adamgreig/wombat/README

WOMBAT Balloon Flight Computer
==============================

Wombat is a flight computer by Cambridge University Spaceflight featuring
onboard STM32F4, uBlox 6 GPS and ADF7012 radio.
