adamgreig/wombat/pcb/gerbers/r1/README.txt

Contents:

wombat.drl              DRILLS

wombat-Back.gbl         BOTTOM COPPER
wombat-Mask_Back.gbs    BOTTOM SOLDERMASK
wombat-SilkS_Back.gbo   BOTTOM SILKSCREEN

wombat-Front.gtl        TOP COPPER
wombat-Mask_Front.gts   TOP SOLDERMASK
wombat-SilkS_Front.gto  TOP SILKSCREEN

wombat-PCB_Edges.gbr    PCB EDGE / ROUTING
