adamgreig/wombat/misc/loopfilter/loop_filter_1_vs_2.png

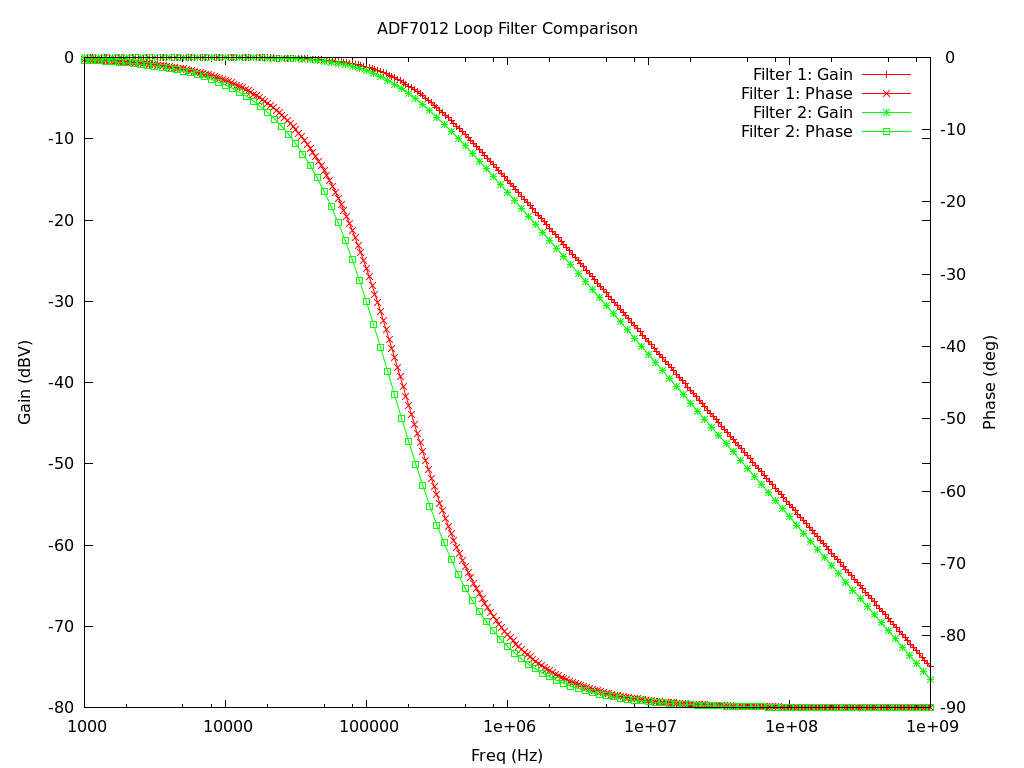
misc/loopfilter/loop_filter_1_vs_2.png
