adamgreig/wombat/misc/temperature_compensation/freq_vs_temp.png

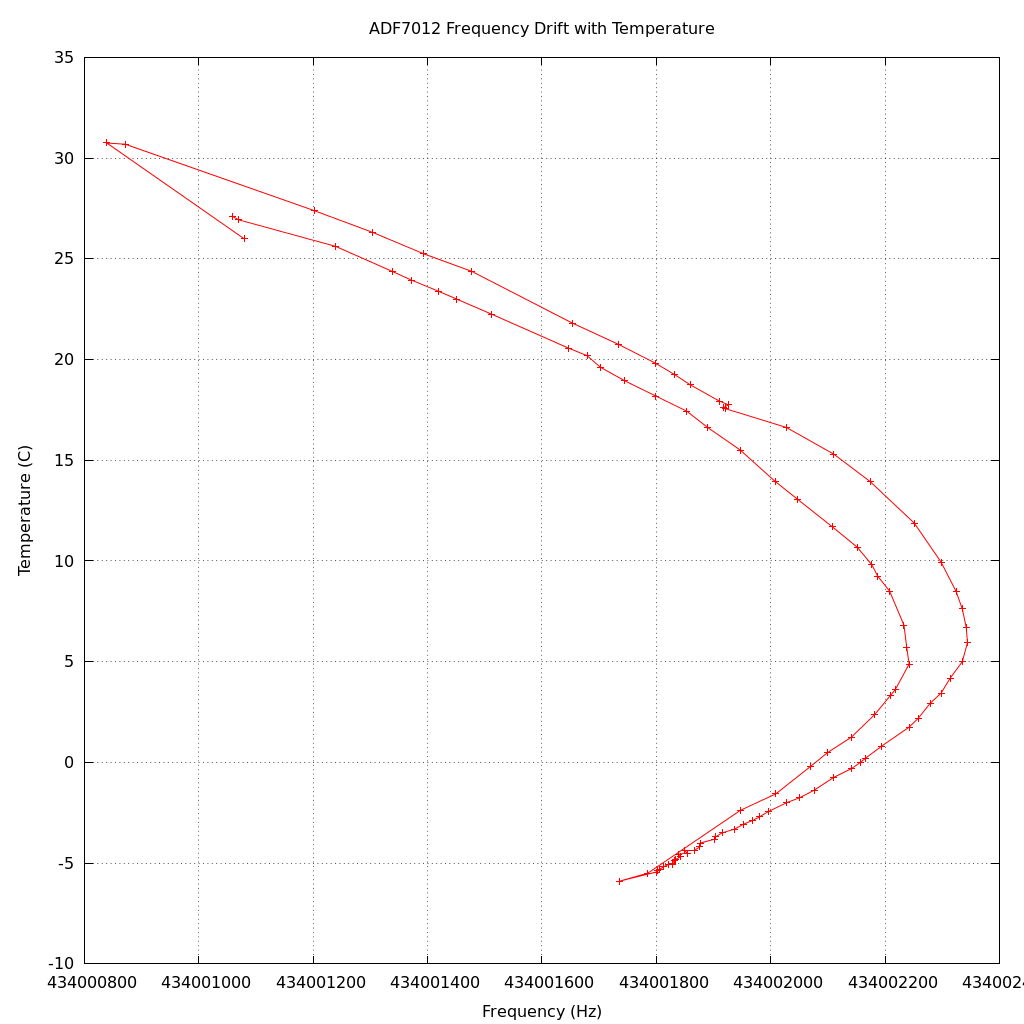
misc/temperature_compensation/freq_vs_temp.png
