adamgreig/wombat/misc/tmp102/sad.png

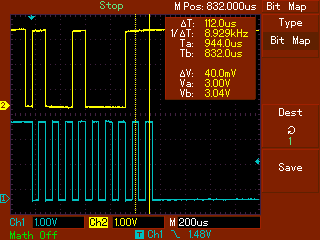
misc/tmp102/sad.png
