adamgreig/wombat/pcb/wombat.pdf

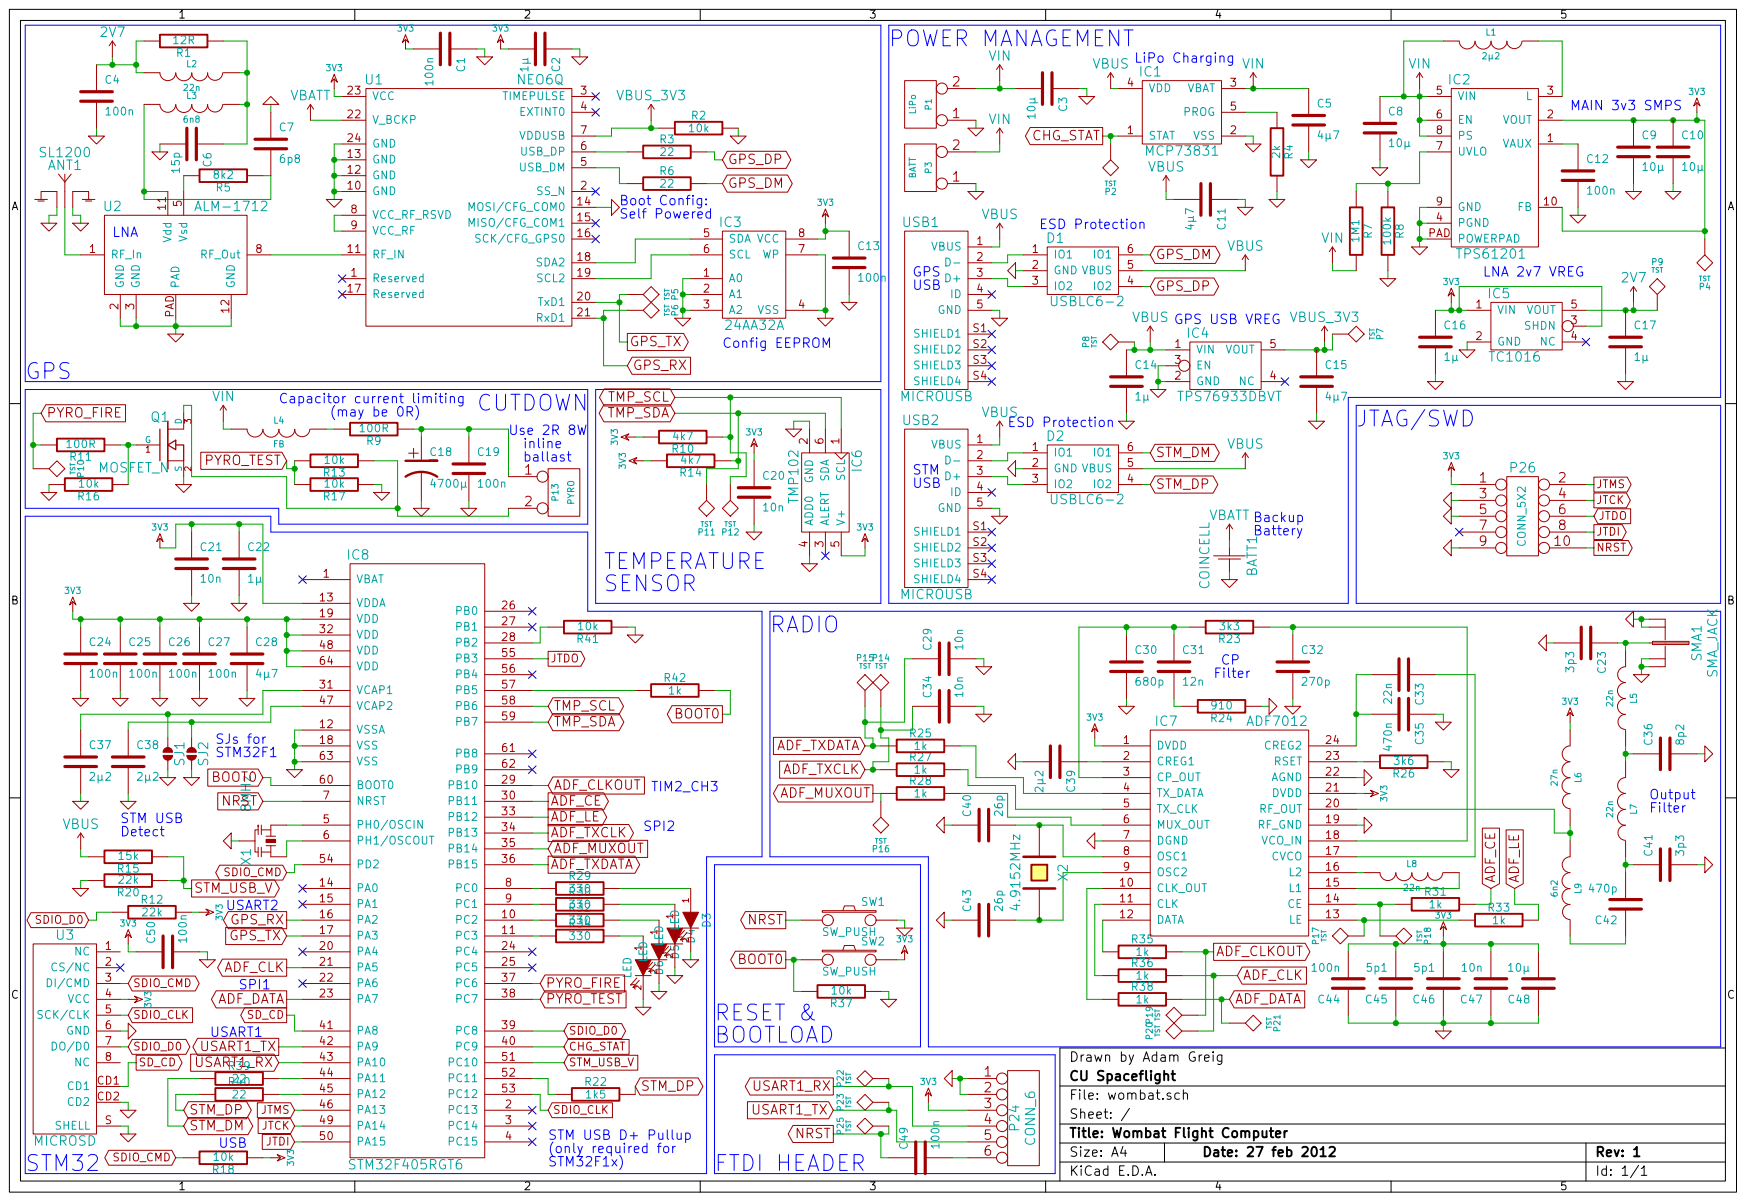
[picture p4: page 1]
