adamgreig/wombat/pcb/wombat.sch

## KiCad design pcb/wombat.sch (2012-03-08, an earlier design)

Schematic: wombat.sch

Parts:
ANT1: SL1200
BATT1: COINCELL; 2032HOLDER; Farnell 1704232
C1, C4, C12, C13, C19, C24, C25, C26, C27, C44, C49, C50: 100n; SM0402; Farnell 1828862
C2, C14, C16, C17, C22: 1µ; SM0402; Farnell 1288253
C3, C8, C9, C10, C48: 10µ; SM0603; Farnell 1735528
C5, C11, C15, C28: 4µ7; SM0603; Farnell 1833803
C6: 15p; SM0402; Farnell 1414577
C7: 6p8; SM0402; Farnell 1800799
C18: 4700µ; RADIAL-5; Farnell 1219459
C20, C21, C29, C34, C47: 10n; SM0402; Farnell 1740589
C23, C41: 3p3; SM0402; Farnell 1702752
C30: 680p; SM0402; Farnell 1865453
C31: 12n; SM0402; Farnell 1865461
C32: 270p; SM0402; Farnell 1414585
C33: 22n; SM0402; Farnell 1414583
C35: 470n; SM0402; Farnell 1414593
C36: 8p2; SM0402; Farnell 7568118
C37, C38, C39: 2µ2; SM0603; Farnell 1833808
C40, C43: 26p; SM0402; Farnell 1414584
C42: 470p; SM0402; Farnell 1535556
C45, C46: 5p1; SM0402; Farnell 1885321
D1, D2: USBLC6-2; SOT-666; Farnell 1295310
D3, D4, D5, D6: LED; SM0603; Farnell 8529850
IC1: MCP73831; SOT-23-5; Farnell 1332158
IC2: TPS61201; Farnell 1564952
IC3: 24AA32A; MSOP8; Farnell 1331296
IC4: TPS76933DBVT; SOT-23-5; Farnell 8461538
IC5: TC1016; SOT-23-5; Farnell 1825051
IC6: TMP102; SOT-563; Farnell 1652477
IC7: ADF7012; TSSOP24; Farnell 1346367
IC8: STM32F405RGT6; LQFP64; Farnell 2064363
L1: 2µ2; SM0805; Farnell 1265551
L2, L5, L7, L8: 22n; SM0402; Farnell 1669580
L3: 6n8; SM0402; Farnell 1669586
L4: FB; SM0603; Farnell 1515757
L6: 27n; SM0402; Farnell 1265429
L9: 6n2; SM0402; Farnell 1265407
P1: LiPo; JST-2mm-2; Farnell 9492615
P2, P4, P5, P6, P7, P8, P9, P10, P11, P12, P14, P15, P16, P17, P18, P19, P20, P21, P22, P23, P25: TST; TP
P3: BATT; BLOCK-3.5mm-2; Farnell 1098611
P13: PYRO; BLOCK-3.5mm-2; Farnell 1098611
P24: CONN_6; HEADER_SMD_6WAY; Farnell 9689508
P26: CONN_5X2; HEADER_SMD_2X5WAY; Farnell 1865279
Q1: MOSFET_N; SOT-23-3; Farnell 1758067
R1: 12R; SM0402; Farnell 1697293
R2, R13, R16, R17, R18, R37, R41: 10k; SM0402; Farnell 1738864
R3, R6, R39, R40: 22; SM0402; Farnell 1739071
R4: 2k; SM0402; Farnell 1358050
R5: 8k2; SM0402; Farnell 1739106
R7: 1M1; SM0402; Farnell 1458741
R8: 100k; SM0402; Farnell 1738877
R9, R11: 100R; SM0402; Farnell 1738837
R10, R14: 4k7; SM0402; Farnell 1738858
R12, R20: 22k; SM0402; Farnell 2059243
R15: 15k; SM0402; Farnell 2059240
R22: 1k5; SM0402; Farnell 2059227
R23: 3k3; SM0402; Farnell 1738856
R24: 910; SM0402; Farnell 1458832
R25, R27, R28, R31, R33, R35, R36, R38, R42: 1k; SM0402; Farnell 1738850
R26: 3k6; SM0402; Farnell 1358057
R29, R30, R32, R34: 330; SM0402; Farnell 1738843
SJ1, SJ2: SJ
SMA1: SMA_JACK; SMA_JACK_END; Farnell 1342651
SW1, SW2: SW_PUSH; SMDSWITCH; Farnell 1607971
U1: NEO6Q
U2: ALM-1712; Farnell 1865149
U3: MICROSD; Farnell 2060731
USB1, USB2: MICROUSB; Farnell 1521869
X1: 8MHz; RESONATOR; Farnell 1615352
X2: 4.9152MHz; HC49; Farnell 1640864

Notes on the sheet:
JTAG/SWD
Use 2R 8W inline ballast
Capacitor current limiting (may be 0R)
RESET & BOOTLOAD
CUTDOWN
TIM2_CH3
STM32
SPI2
USB
USART1
SPI1
USART2
SJs for STM32F1
FTDI HEADER
TEMPERATURE SENSOR
Boot Config: Self Powered
CP Filter
Output Filter
RADIO
LNA
Config EEPROM
STM USB Detect
STM USB D+ Pullup (only required for STM32F1x)
MAIN 3v3 SMPS
Backup Battery
LNA 2v7 VREG
GPS USB VREG
STM USB
GPS USB
ESD Protection
LiPo Charging
GPS
POWER MANAGEMENT
