adamgreig/wombat/code/clock.c

#include "clock.h"

#include <libopencm3/stm32/f4/rcc.h>

void clock_setup(void) {
    rcc_clock_setup_hse_3v3(&hse_8mhz_3v3[CLOCK_3V3_120MHZ]);
    rcc_peripheral_enable_clock(&RCC_AHB1ENR, RCC_AHB1ENR_IOPAEN);
    rcc_peripheral_enable_clock(&RCC_AHB1ENR, RCC_AHB1ENR_IOPBEN);
    rcc_peripheral_enable_clock(&RCC_AHB1ENR, RCC_AHB1ENR_IOPCEN);

    rcc_peripheral_enable_clock(&RCC_APB1ENR, RCC_APB1ENR_USART2EN);
    rcc_peripheral_enable_clock(&RCC_APB2ENR, RCC_APB2ENR_USART1EN);

    rcc_peripheral_enable_clock(&RCC_APB1ENR, RCC_APB1ENR_I2C1EN);
}
