adamgreig/wombat/(commit log)

2011-10-08 First commit. Wombat radio schematic done.
    [con.sch, micro.sch, power.sch, radio.sch, wombat.brd, wombat.sch]
2011-10-24 added gps module and some diodes
    [con.sch, daughter.sch, daughterboard_con.sch, gps.sch, lipo.sch, micro.sch, power.sch, radio.sch]
2012-02-19 committing some changes
    [con.sch, daughter.sch, daughterboard_con.sch, gps.sch, lipo.sch, micro.sch, power.sch, radio.sch]
2012-02-19 more changes
    [daughter.sch, daughterboard_con.sch, gps.sch, lipo.sch]
2012-02-19 clean up in prep for take2
    [con.sch, daughter.sch, daughterboard_con.sch, gps.sch, lipo.sch, micro.sch, power.sch, radio.sch]
2012-02-19 Generate pretty much all the schematic parts that'l be needed.
    [wombat.sch]
2012-02-19 schematic finished, parts specced for gps
    [wombat.sch]
2012-02-19 spec cutdown parts
    [wombat.sch]
2012-02-19 spec temp sensor parts
    [wombat.sch]
2012-02-19 spec all stm parts
    [wombat.sch]
2012-02-19 spec ftdi parts
    [wombat.sch]
2012-02-19 spec reset and bootload parts
    [wombat.sch]
2012-02-22 stm32 to resonator and cutdown updated
    [wombat.sch]
2012-02-22 update load caps on adf crystal 18->26pF (so that total C_L=18pF)
    [wombat.sch]
2012-02-22 radio section all specced
    [wombat.sch]
2012-02-22 spec all power parts
    [wombat.sch]
2012-02-22 fix incorrect farnell code for 3k6 resistor
    [wombat.csv, wombat.sch]
2012-02-23 add a load of footprints
2012-02-23 swap boot0 pull to a pulldown, switch pulls it up, oops
    [wombat.sch]
2012-02-25 tidy up sch - remove silly d+ pullup, connect boot0 button to a gpio, add jtag header
    [wombat.sch]
2012-02-25 made many more footprints
2012-02-25 respec jtag header for shrouded version
    [wombat.sch]
2012-02-25 respec cheaper and more available jtag header
    [wombat.sch]
2012-02-26 jtag header done, ready to rock and roll
    [wombat.sch]
2012-02-26 move to 2x5 jtag header. all parts placed.
    [wombat.brd, wombat.sch]
2012-02-26 add micro sd card and begin the routing
    [wombat.brd, wombat.sch]
2012-02-27 ONE LAST TRACE, ONE TRACE MORE
    [wombat.brd, wombat.sch]
2012-02-27 woo CONNECT ALL THE NETS
    [wombat.brd]
2012-02-27 r1 done.
    [wombat-Back.gbl, wombat-Front.gtl, wombat-Mask_Back.gbs, wombat-Mask_Front.gts, wombat-PCB_Edges.gbr, wombat-SilkS_Back.gbo, wombat-SilkS_Front.gto, wombat-SoldP_Front.gtp]
2012-02-27 update BOM
    [wombat.csv]
2012-03-04 Code working! Just dances some LEDs but build chain all works. Using libopencm3 via git submodule.
    [stm32f4x.cfg, wombat.cfg]
2012-03-04 Update working size for openocd config to 128K
    [wombat.cfg]
2012-03-08 Change loop filter design, hopefullying helping fix #20
    [wombat.sch]
2012-03-20 add various misc files
    [1.csv, 2.csv]
2012-03-22 temperature sensing is working woo
2012-03-22 change LED functions to make them slightly better
2012-03-26 Use GPS polling, including checking fix is valid
    [gps.c, gps.h, wombat.c]
2012-03-26 put temperature in sentence
2012-03-26 better LED debugging
2012-03-26 fix some indentation messiness
    [clock.c, hardfault.c]
2012-03-26 reset config in adf_setup()
    [adf.c]
2012-03-26 code to just transmit temperature for calibration
2012-03-26 remove temperature calibration test code
2012-03-26 add more misc stuff including frequency drift with temperature
2013-09-10 missed u64. of course.
    [adf.c]
2013-09-10 add prototypes for everything to clean up build warnings
