adamgreig/wombat/(notices)

Notices in the files:
code/stm32loader.py:
stm32loader is free software; you can redistribute it and/or modify it under
the terms of the GNU General Public License as published by the Free
